PhotonKrane/MedicaBox_TCC/README.md

**US README** | [PT-BR README](https://github.com/PhotonKrane/MedicaBox_TCC/blob/main/README.pt-BR.md)

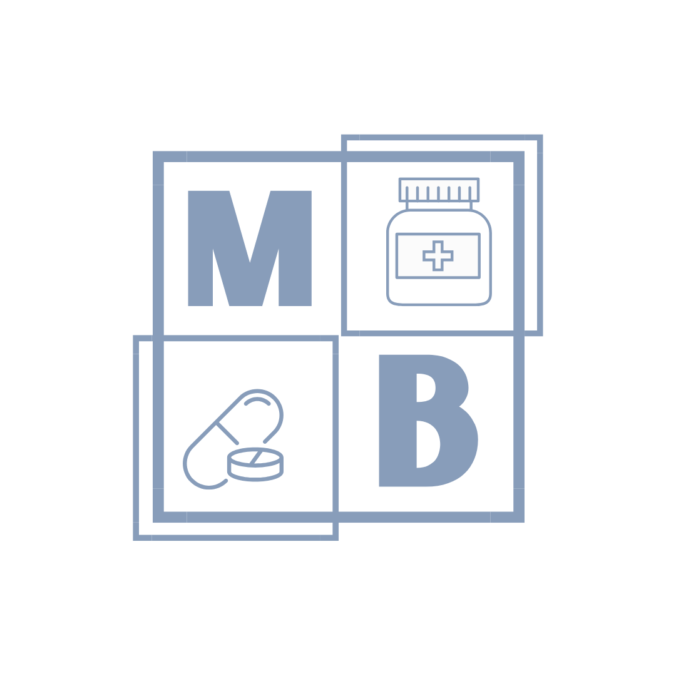
[picture p1: TCC/media/Logo/MedicaBox Logo.png]
Logo MedicaBox
#  MedicaBox TCC 💊

Prototipo MedicaBox

### The project's source code is licensed under the MIT License, as specified in the LICENSE document; therefore, documents, photos, and other elements distinct from the programming code are NOT made available.

## 📘 About the Project:
MedicaBox is an automated medication organizer integrated with an Android application. The system allows users to configure their profiles, organize medicines by compartments, schedule medication times, and receive notifications through the mobile app. The physical device uses embedded electronics to automatically identify and dispense the correct medication at the configured time, while the application provides an intuitive interface for managing users, medicines, and schedules. The project combines IoT, embedded systems, and mobile development concepts to create a solution focused on improving medication organization and adherence.

## 🙍 Members:
**- Beatriz Cerioni**
**- Caio Sales**
**- Gabriela Furucho**
**- Isaac Correa**
**- Pedro Lerio**
**- Tiago Oliveira**

## 📱 Technologies
  **- Mobile Programming**\
  **- Embedded Systems**\
  **- Electronics**\
  **- Android Studio**\
  **- Firebase**\
  **- ESP32 Wi-Fi Communication**\
  **- Microcontroller ESP32**

## ☑️ Summary:
**Monograph**: [Final Monograph](https://github.com/PhotonKrane/MedicaBox_TCC/blob/main/TCC/docs/Monograph/Final%20Monograph.pdf)\
**Monograph Resume**: [Monograph_Resume](https://github.com/PhotonKrane/MedicaBox_TCC/blob/main/TCC/docs/Monograph/Monograph_Resume.pdf)\
**Mobile Code**: [MedicaBox_Final_Project_App](https://github.com/PhotonKrane/MedicaBox_TCC/tree/main/TCC/codes/android/MedicaBox_Final_Project_App/MedicaBox_Final_Project_App-master)\
**Flowcharts**: [Flowcharts](https://github.com/PhotonKrane/MedicaBox_TCC/blob/main/TCC/docs/Flowcharts/Flowcharts.pdf)
**Firmware Code**: [Final_Project_Firmware_Program](https://github.com/PhotonKrane/MedicaBox_TCC/tree/main/TCC/codes/firmware/Final_Project_Firmware_Program)\
**Logo**: [MedicaBox Logo](https://github.com/PhotonKrane/MedicaBox_TCC/blob/main/TCC/media/Logo/MedicaBox%20Logo.png)\
**Functional Prototype**: [Final Test](https://github.com/PhotonKrane/MedicaBox_TCC/blob/main/TCC/media/Embadded/Videos/Final_Test.mp4)\
**Schematic**: [Schematic Diagram](https://github.com/PhotonKrane/MedicaBox_TCC/blob/main/TCC/codes/hardware/Schematic/Schematic%20Diagram.png)

### YOU WANT TO KNOW MORE ABOUT THE PROJECT, YOU CAN SEE MORE INFO [HERE](https://github.com/PhotonKrane/MedicaBox_TCC/tree/main/TCC)

📌 Above all else, this project was a milestone in my life as a programmer; it was the very first programming project I ever worked on.📌
