PhotonKrane/MedicaBox_TCC/TCC/media/Embadded/Photos/Technical_Adjustments.jpg

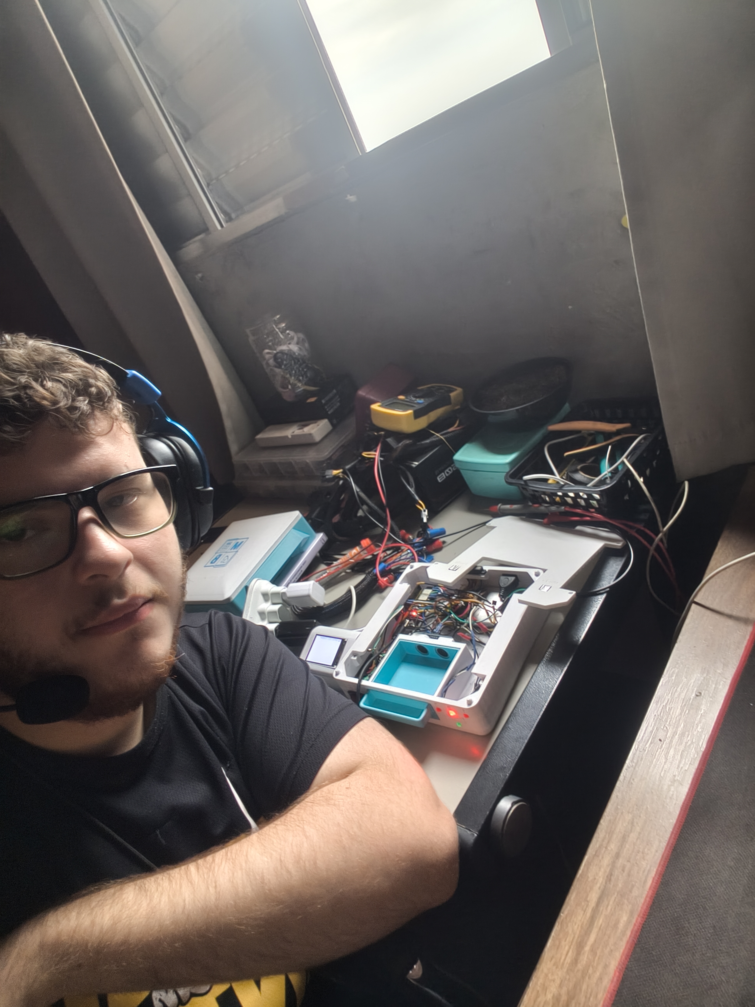
TCC/media/Embadded/Photos/Technical_Adjustments.jpg
