PhotonKrane/MedicaBox_TCC/TCC/media/Final Presentation/App_Photo.jpg

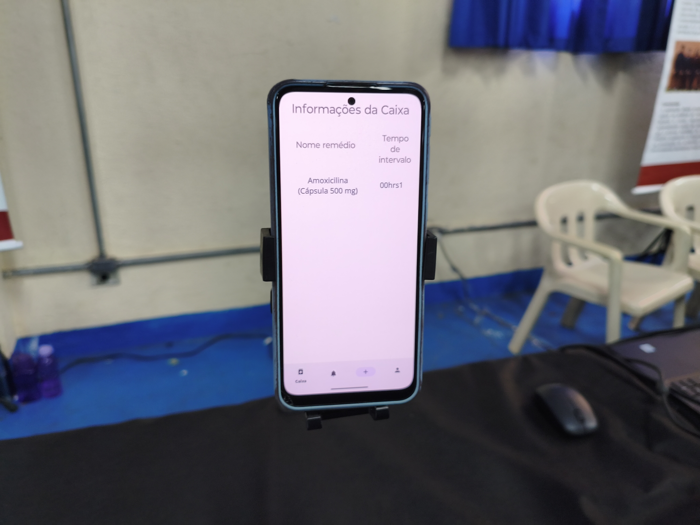
TCC/media/Final Presentation/App_Photo.jpg
