PhotonKrane/MedicaBox_TCC/TCC/media/Prototype/Photo_First_Floor.jpg

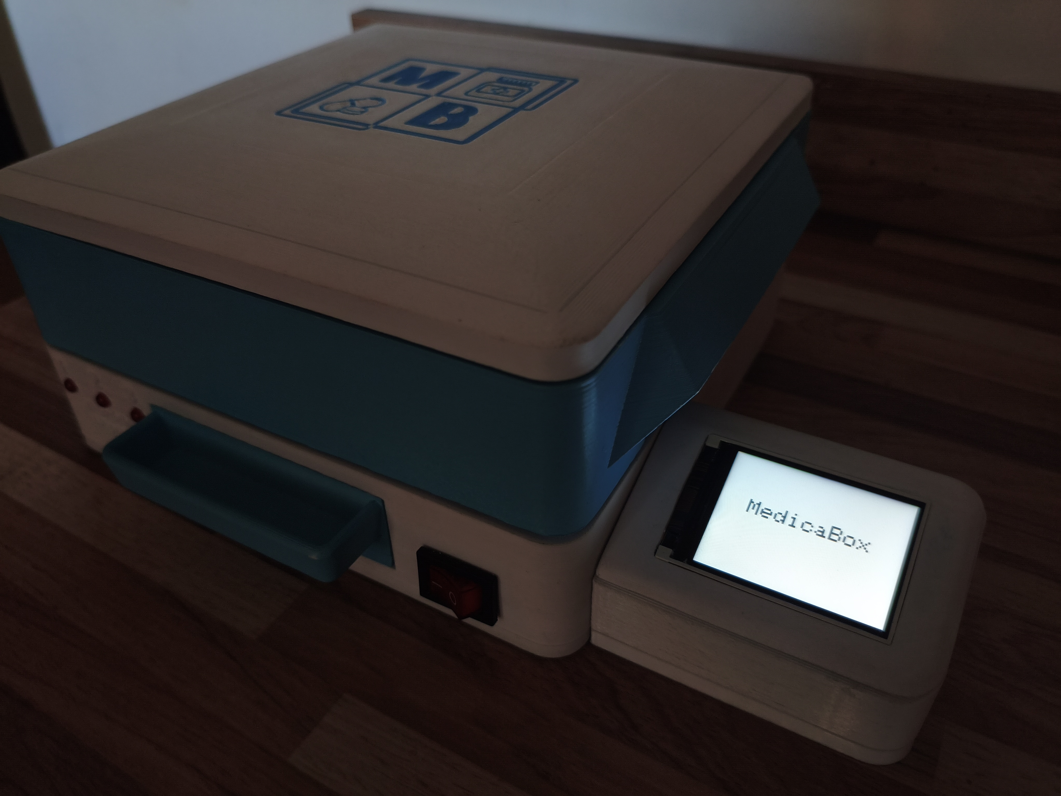
TCC/media/Prototype/Photo_First_Floor.jpg
