PhotonKrane/MedicaBox_TCC/TCC/media/Prototype/Prototype_Photo.jpg

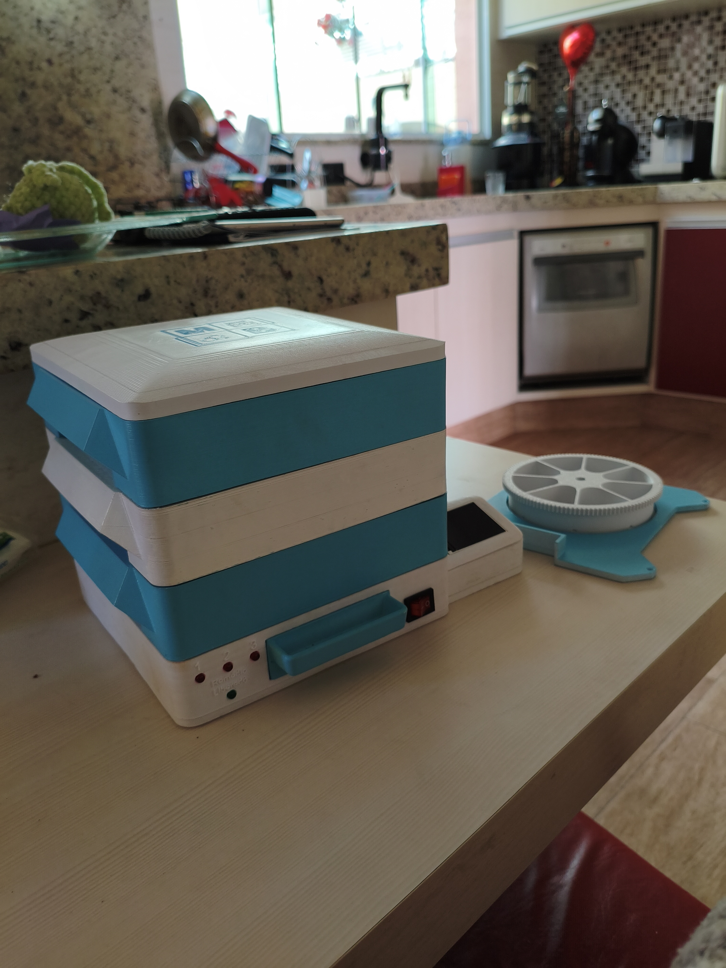
TCC/media/Prototype/Prototype_Photo.jpg
