PhotonKrane/MedicaBox_TCC/TCC/media/Embadded/Photos/Display_Test.jpg

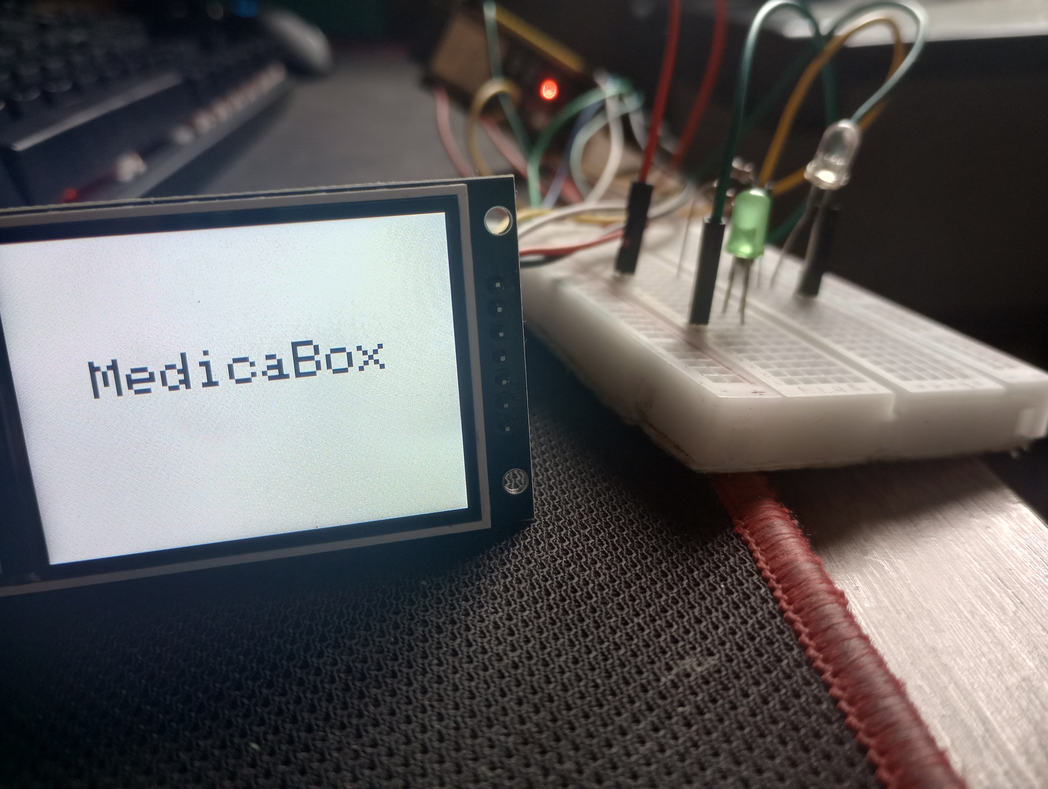
TCC/media/Embadded/Photos/Display_Test.jpg
