PhotonKrane/MedicaBox_TCC/TCC/media/Embadded/Photos/Prototype_Test.jpg

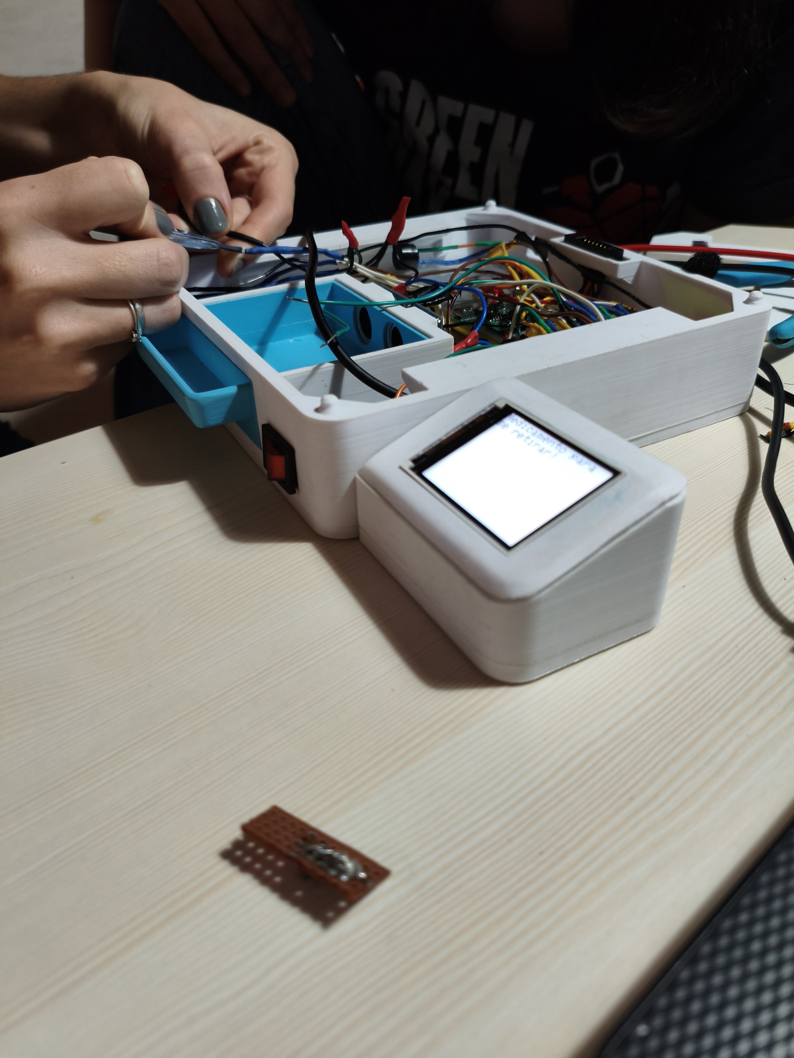
TCC/media/Embadded/Photos/Prototype_Test.jpg
