PhotonKrane/MedicaBox_TCC/TCC/media/Embadded/Photos/WiFiManager_Test.jpg

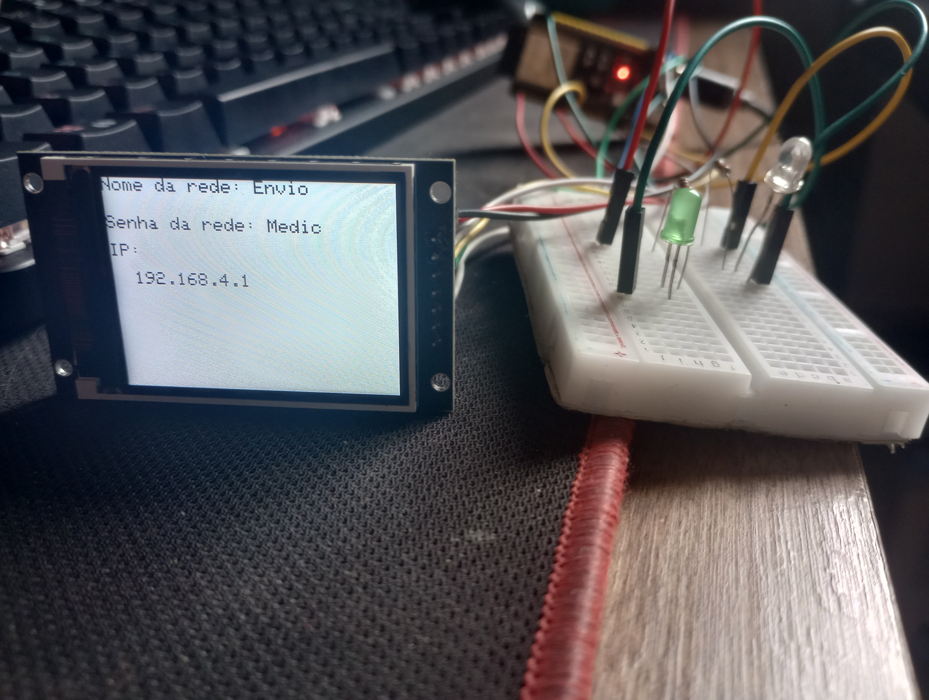
TCC/media/Embadded/Photos/WiFiManager_Test.jpg
